keatinl1/Motor_System_ID_and_PID_Control/(commit log)

2025-07-24 motor moving
2025-07-25 working now thank god, didnt burn it out
    [dc_motor_id_and_control.ino]
2025-07-29 set motor speed with v now, outputs ang vel now, still crashes sometimes
    [dc_motor_id_and_control.ino]
2025-07-29 double checked, happy w edge case handling
2025-07-29 made filter a little less aggressive
2025-07-29 pid controller done
2025-07-30 upload circuit
